UAA-F14/PID-RLC/doc/PY2.pdf

# Proyecto Intermedio - Diseño e Implementación de un Controlador PID Analógico para una Planta RLC de Tercer Orden

Contreras R. Orlando¹

, García B. Iker¹

, Lara H. Kevin¹

1Departamento de Sistemas Electrónicos, Universidad Autónoma de Aguascalientes, Av. Universidad 940, Aguascalientes, 20131, Aguascalientes, México.

Contributing authors: {al348390, al307630, al464376}@edu.uaa.mx;

Abstract

En este proyecto se diseñó, simuló e implementó un controlador PID analógico en forma paralela, construido con amplificadores operacionales TL082, para mejorar la respuesta transitoria de una planta RLC serie subamortiguada. La sintonía inicial se obtuvo por el método de oscilaciones sostenidas de Ziegler-Nichols, Debido a que esta sintonía genera un sobrepaso, se realizó un ajuste fino en MATLAB, con lo cual se obtuvo un sobrepaso de 7.6 %, error en estado estable nulo y un tiempo de asentamiento de 714 µs, menor que los 790 µs de lazo abierto. El diseño se trasladó a valores de resistencias y capacitores y se verificó en LTspice.

Keywords: Control PID, Ziegler-Nichols, Oscilaciones sostenidas, Circuito RLC, Amplificador operacional, Filtro derivativo, MATLAB, LTspice.

## 1 Objetivo

Diseñar, simular, construir y evaluar un controlador PID analógico, implementado con amplificadores operacionales, que mejore la respuesta transitoria de una planta RLC subamortiguada, obteniendo la sintonía inicial mediante el método de oscilaciones sostenidas (Ziegler-Nichols en lazo cerrado) y refinándola mediante simulación en MATLAB, de manera que el sistema en lazo cerrado cumpla con las siguientes especificaciones:
- Error en estado estable nulo (ess = 0).
- Sobrepaso máximo Mp ≤ 15 %.
- Tiempo de asentamiento menor que el de lazo abierto.

## 2 Materiales y Metodología

- Inductor de 10 mH
- Capacitores de 100 nF, 10 nF y 1 nF
- Resistencias y Trimpots
- Amplificadores operacionales TL082
- Fuente de alimentación dual de ±12 V
- Generador de funciones (señal cuadrada de 0 a 1 V, 100 Hz)
- Osciloscopio digital y multímetro
- Protoboard, cables de conexión y sondas

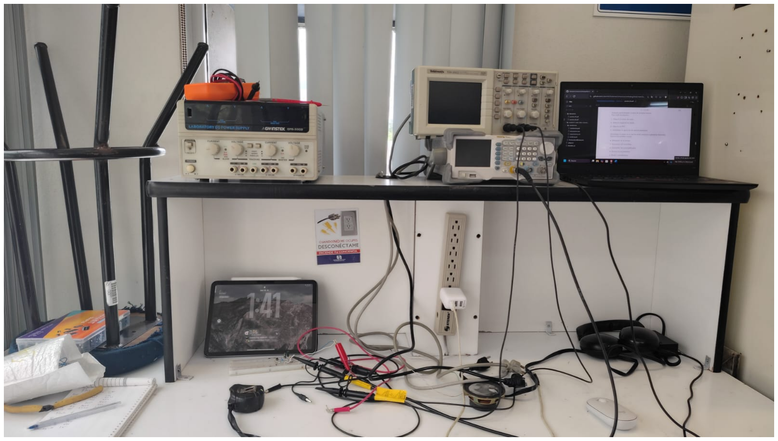
[picture p9: figure]

Fig. 1: Materiales

### 2.1 Modelado de la Planta

La planta se compone de un circuito RLC serie con salida en el capacitor, seguido de un seguidor de tensión, una etapa RC y un segundo seguidor de tensión. La resistencia total del lazo está formada por R50 = 58 Ω y R35 = 100 Ω en serie, más la resistencia DC del inductor (DCR) y la resistencia de salida del amplificador que excita al circuito. La función de transferencia del RLC es

GRLC (s) = VC (s)
U(s)

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
2 + 2ζωns + ω²
n

,

con

ωn =

1
√
LC

=

1
p
(10 mH)(100 nF)

= 31 623 rad/s (5.03 kHz),

ζ =

R
2

r
C
L

=

158.1
2

r
100 nF
10 mH

= 0.25.

El valor de ζ queda dentro del intervalo requerido 0.15 ≤ ζ ≤ 0.35. Para este amortiguamiento, el RLC por sí solo presenta un sobrepaso teórico

Mp = e

−ζπ/√
1−ζ

2
× 100 % = 44.4 %, ts ≈

4
ζωn

= 506 µs.

La etapa RC adicional (R49 = 20 kΩ, C14 = 10 nF) introduce un polo real en

GRC (s) = 1
τs + 1

, τ = R49C14 = 200 µs ⇒ p3 = −5 000 rad/s.

Los seguidores de tensión U20 y U21 aíslan las etapas, de modo que la planta completa resulta en el producto de ambas funciones:

H(s) = GRLC (s) GRC (s) = | ω

2
n
s
| 2 + 2ζωns + ω²
n

1
τs + 1

=

5 × 10¹²
s

3 + 20 811 s

2 + 1.079 × 10⁹ s + 5 × 10¹² ,

cuyos polos son s1,2 = −7 905±j30 618 rad/s y s3 = −5 000 rad/s. La ganancia en DC es H(0) = 1.

### 2.2 Sintonía Inicial: Método de Oscilaciones Sostenidas

Con las acciones integral y derivativa desactivadas (Ki = 0, Kd = 0), se incrementó la ganancia proporcional hasta obtener una oscilación sostenida de amplitud constante a la salida, sin saturar los amplificadores. En el modelo, la ganancia última se obtiene con margin(H) como el margen de ganancia, y el periodo último a partir de la frecuencia de cruce de fase de −180◦
:
Kcr = 3.49 (10.86 dB), | ωcr = 32 848 rad/s, | Pcr =

2π

ωcr

= 191.3 µs (5.23 kHz).

El mismo resultado se observa en el lugar de las raíces (Figura ??), donde las ramas de los polos complejos cruzan el eje imaginario en s = ±j32 848 rad/s para K = 3.49.

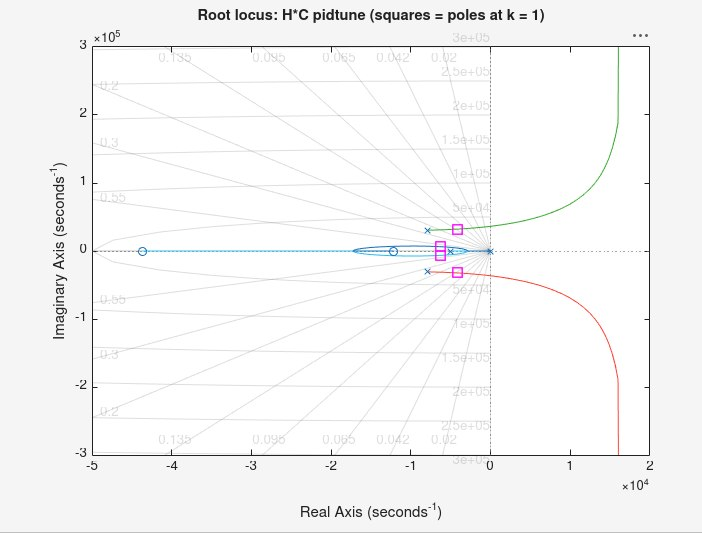
[picture p10: figure]

Fig. 2: Lugar de las raíces de H(s) con control proporcional.

Aplicando la tabla de Ziegler-Nichols para un controlador PID:

Kp = 0.6Kcr = 2.09, Ti =

Pcr
2

= 95.6 µs, Td =

Pcr
8

= 23.9 µs,

y las ganancias independientes de cada rama del circuito son

Ki =

Kp
Ti

= 2.19 × 10⁴
s

−1

, Kd = KpTd = 5.0 × 10⁻⁵
s.

### 2.3 Simulación y Ajuste Fino en MATLAB

El controlador se modeló en forma paralela,

C(s) = Kp +

Ki
s

+ Kds,

y el lazo cerrado con realimentación unitaria como Gp(s) = C(s)H(s) 1 + C(s)H(s)
. Se simuló

la respuesta al escalón con step y se obtuvieron las métricas con stepinfo (criterio de asentamiento del 2 %). El código completo se presenta en el Apéndice ??.

La sintonía de Ziegler-Nichols produce una respuesta rápida, pero con Mp = 18.2 %, que excede la especificación de 15 %. A partir de ella, el ajuste fino se realizó con el siguiente criterio:

1. Reducción de Kp de 2.09 a 1.5: el sobrepaso de Ziegler-Nichols proviene principalmente de la cercanía a la ganancia crítica (Kp/Kcr = 0.6). Al reducir la relación a 0.43, los polos dominantes se alejan del eje imaginario y el sobrepaso disminuye.
2. Reducción de Ki de 2.19×10⁴ a 1.2×10⁴
s

−1
(Ti = 125 µs): una acción integral más suave reduce la acumulación de error durante el transitorio y el sobrepaso asociado, sin perder el error en estado estable nulo.
3. Aumento de Kd de 5.0×10⁻⁵ a 6.7×10⁻⁵
s (Td = 44.7 µs): la acción derivativa adicional aporta fase en la zona de cruce y amortigua el modo oscilatorio del RLC.

Con estos valores, el lazo cerrado tiene polos en −5 655 ± j35 027 rad/s y −4 751 ± j5 009 rad/s, un margen de ganancia de 28.5 dB y un margen de fase de 81.6

◦
(Figura
??).

### 2.4 Diseño del Circuito

El controlador se implementó en forma paralela (Figura ??) con cinco etapas:
- Restador (U15): con R36 = R37 = R38 = R39 = 10 kΩ entrega e(t) = r(t)−y(t), donde y(t) es la salida del seguidor U21.
- Rama proporcional (U16): amplificador inversor con ganancia −R43/R40.
- Rama integral (U17): integrador inversor con función de transferencia −1/(R41C12s).
- Rama derivativa (U18): derivador inversor con R42 en serie con C13, que limita la ganancia en alta frecuencia (filtro derivativo):

CD(s) = −

R44C13 s
R42C13 s + 1

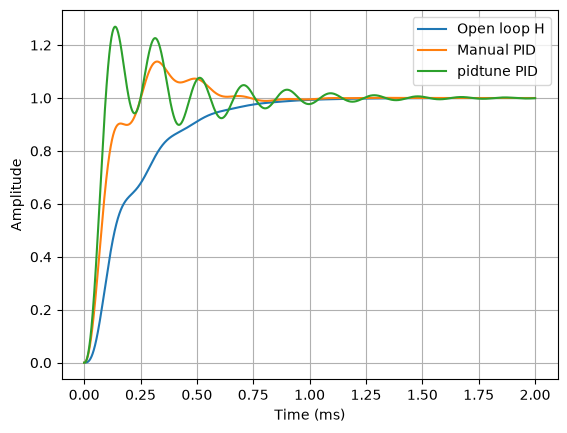
[picture p11: figure]

Fig. 3: Comparación PID manual y PID-Tune

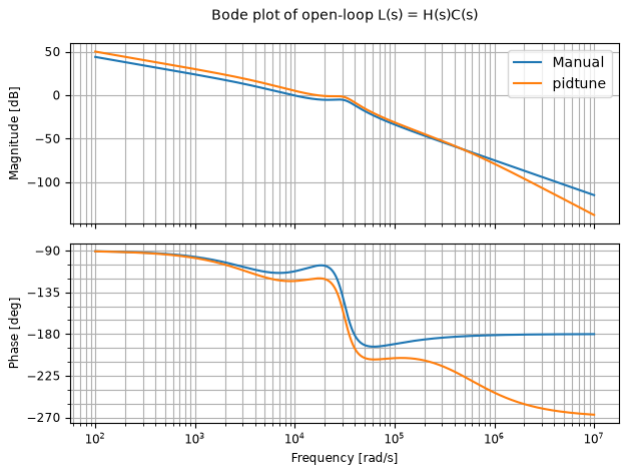
[picture p12: figure]

Fig. 4: Diagrama de Bode de la planta H(s) y del lazo abierto compensado C(s)H(s).

- Sumador inversor (U19): con R45 = R46 = R47 = R48 = 10 kΩ suma las tres ramas y corrige el signo, de modo que la doble inversión entrega u(t) con signo positivo.

Los valores de componentes se obtuvieron a partir de las ganancias finales (Tabla ??).

Table 1: Cálculo de los componentes del PID analógico.

Rama | Relación | Componentes | Ganancia obtenida
P | Kp = R43/R40 | R40 = 10 kΩ, R43 = 15 kΩ | Kp = 1.5
I | Ki = 1/(R41C12) | R41 = 83.33 kΩ, C12 = 1 nF | Ki = 1.2 × 10⁴ s⁻¹
D | Kd = R44C13 | R44 = 65 kΩ, C13 = 1 nF | Kd = 6.5 × 10⁻⁵ s
Filtro D | τf = R42C13 | R42 = 2.4 kΩ | τf = 2.4 µs

R41 = 83.33 kΩ no es un valor comercial; se implementa con 82 kΩ + 1.3 kΩ en serie o con un potenciómetro de 100 kΩ ajustado. Para R44 se usó 65 kΩ, lo que da Kd = 6.5×

10⁻⁵

s, 3 % por debajo del valor de diseño; con 68 kΩ (E12) se obtendría 6.8 × 10⁻⁵ s.
El polo del filtro derivativo queda en 1/τf = 417 krad/s, unas 13 veces por encima de ωn, de modo que no afecta la dinámica de interés y sí limita la amplificación del ruido de alta frecuencia. Para el reinicio del integrador se agrega un interruptor en paralelo con C12, que se cierra durante la búsqueda de Kcr y antes de cada prueba al escalón.

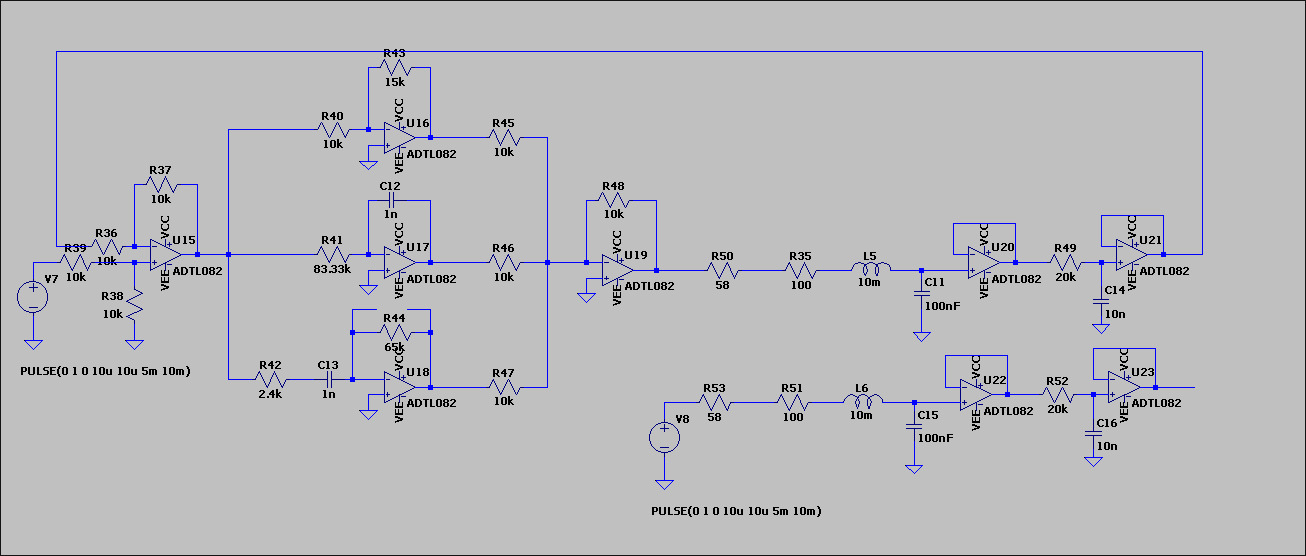
[picture p13: figure]

Fig. 5: Esquemático en LTspice del sistema completo: restador, ramas P, I y D, sumador, planta RLC con etapa RC en lazo cerrado (arriba) y planta en lazo abierto de referencia (abajo).

En LTspice se simuló el sistema completo con amplificadores TL082 y una señal de referencia PULSE(0 1 0 10u 10u 5m 10m). Además del lazo cerrado, se incluyó una copia de la planta excitada directamente por la misma señal (V8), para comparar las respuestas de lazo abierto y lazo cerrado en una sola simulación.

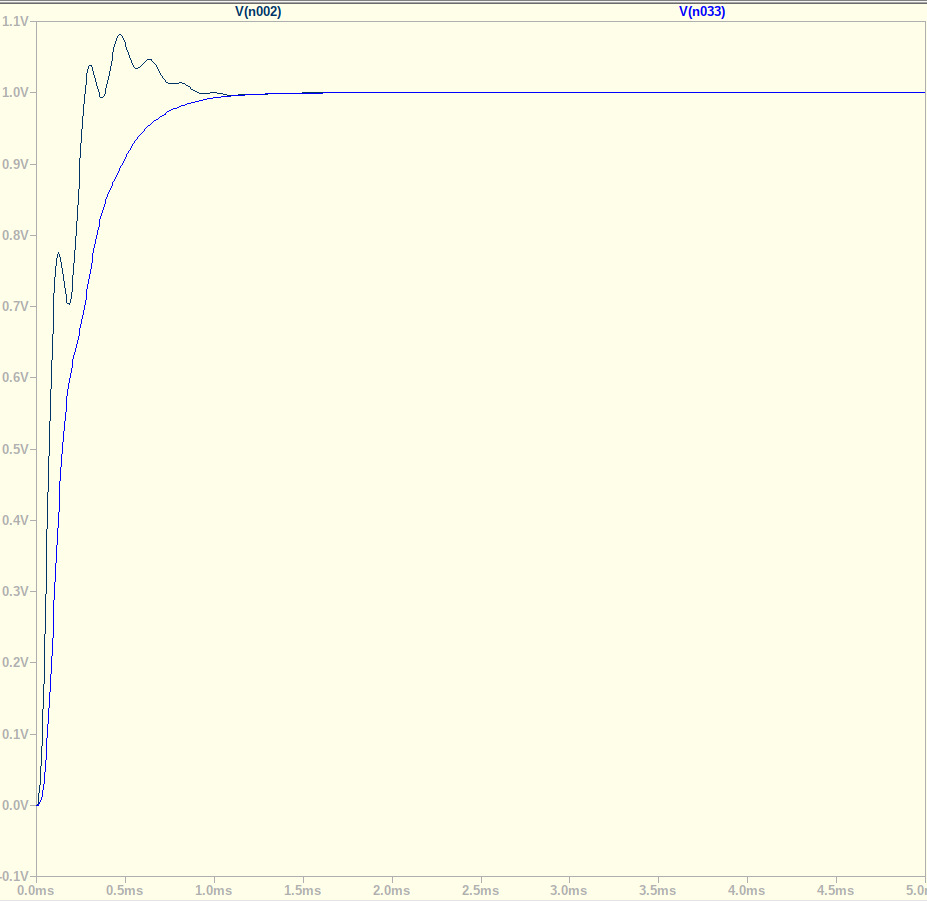
[picture p14: figure]

Fig. 6: Comparación planta sin control y con control

## 3 Resultados

### 3.1 Comparación de las Respuestas Simuladas

La Figura ?? compara la respuesta al escalón de la planta en lazo abierto, el lazo cerrado con la sintonía de Ziegler-Nichols y el lazo cerrado con el ajuste fino. La Tabla ?? resume las métricas obtenidas con stepinfo.

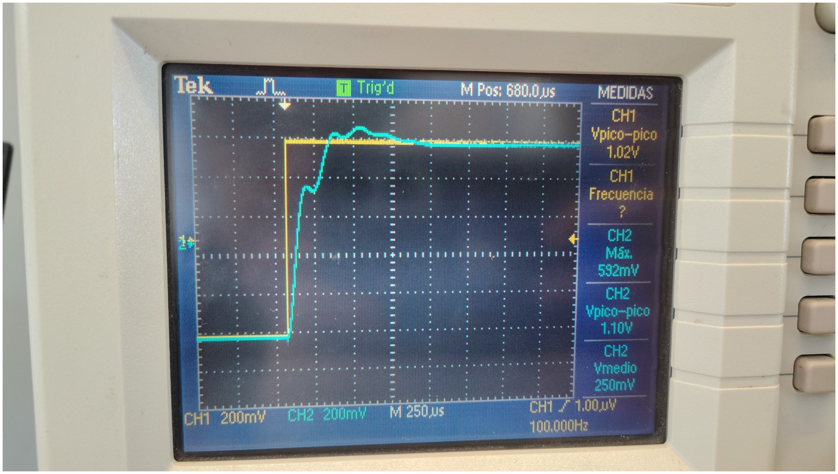
[picture p15: figure]

Fig. 7: Respuesta al escalón unitario

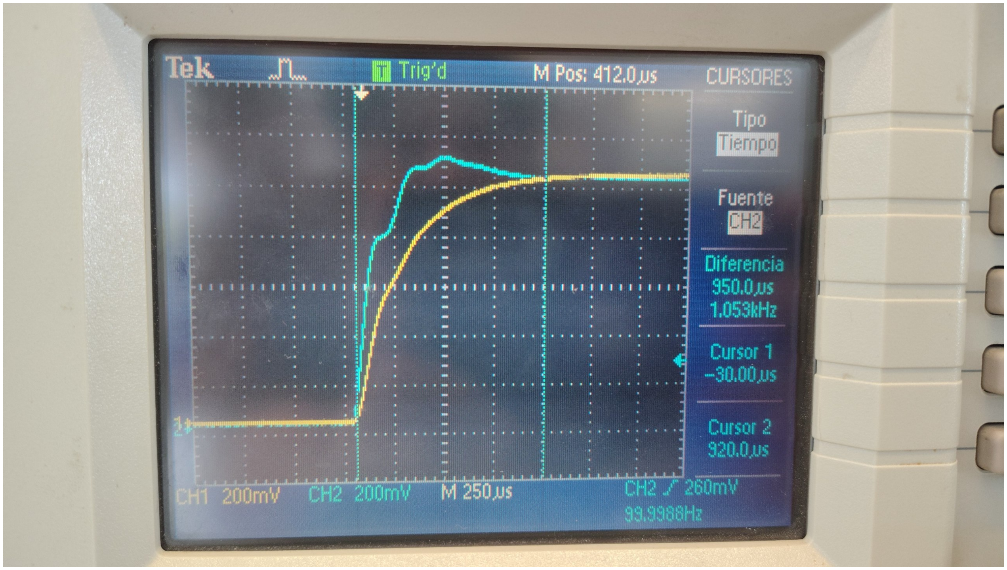
[picture p16: figure]

Fig. 8: Comparación planta sin control y con control

Table 2: Métricas de la respuesta al escalón (criterio de asentamiento del 2 %).

Métrica | Lazo abierto | PID Z-N | PID ajustado | PID circuito∗
Tiempo de subida tr | 422 µs | 71 µs | 213 µs | 212 µs
Tiempo pico tp | – | 304 µs | 462 µs | 463 µs
Sobrepaso Mp | 0 % | 18.2 % | 7.6 % | 8.1 %
Tiempo de asentamiento ts | 790 µs | 615 µs | 714 µs | 708 µs
Error en estado estable ess | 0 | 0 | 0 | 0

∗Valores reales de componentes, incluyendo el filtro derivativo (τf = 2.4 µs).

La sintonía de Ziegler-Nichols reduce el tiempo de asentamiento a 615 µs, pero su sobrepaso de 18.2 % no cumple la especificación. El PID con ajuste fino cumple las tres especificaciones: Mp = 7.6 % ≤ 15 %, ess = 0 gracias a la acción integral y ts = 714 µs < 790 µs. Además, reduce el tiempo de subida casi a la mitad respecto al lazo abierto (213 contra 422 µs). Con los valores reales de componentes, el filtro derivativo y la diferencia en R44 apenas modifican la respuesta (Mp = 8.1 %, ts = 708 µs).

Cabe señalar que la mejora en el tiempo de asentamiento es moderada (≈ 10 %), ya que la planta de tercer orden no presenta sobrepaso en lazo abierto, y el PID cambia una respuesta lenta sin sobrepaso por una más rápida con un sobrepaso pequeño. La principal ganancia del controlador está en la velocidad de respuesta (tr) y en la robustez del error en estado estable nulo ante variaciones de la planta.

## 4 Análisis y Discusión

Las diferencias esperadas entre la simulación y la medición se deben a varios factores:
- Resistencia DC del inductor y resistencia de salida del amplificador: ambas se suman a los 158 Ω de la resistencia serie, por lo que incrementan ζ. Por ejemplo, una DCR de 20 Ω elevaría ζ de 0.25 a 0.28, lo que modifica Kcr y Pcr.
- Tolerancias de los componentes: un error de ±10 % en L o C desplaza ωn cerca de un ±5 %. Las tolerancias de R49 y C14 cambian el polo dominante de la etapa RC, que es el que más influye en el tiempo de asentamiento.
- Producto ganancia-ancho de banda (GBW): el TL082 tiene un GBW de 3 MHz. A la frecuencia de oscilación (5.23 kHz) las ramas P e I operan sin problema, pero el derivador tiene ganancia alta en frecuencia, por lo que su respuesta real se aparta del modelo ideal por encima de unos cientos de kHz y añade un desfase adicional al lazo.
- Saturación y slew rate: el pico derivativo ante el escalón satura la rama D durante algunos microsegundos. Además, el slew rate del TL082 (13 V/µs) limita la rapidez de ese pico.
- Limitaciones del método de Ziegler-Nichols: es una regla empírica que busca una razón de decaimiento de aproximadamente 1/4, por lo que suele producir sobrepasos altos (18.2 % en este caso). Además, requiere llevar el sistema al límite de estabilidad, lo que en un sistema real implica el riesgo de saturar los amplificadores durante la prueba. Por ello, la sintonía obtenida se toma solo como punto de partida para el ajuste fino.

## 5 Conclusiones

Se diseñó un controlador PID analógico en forma paralela para una planta RLC de tercer orden con ωn = 31.62 krad/s y ζ = 0.25. La etapa RC adicional permitió que la planta alcanzara el límite de estabilidad con una ganancia proporcional finita (Kcr = 3.49, Pcr = 191.3 µs), lo que hizo posible aplicar el método de oscilaciones sostenidas de Ziegler-Nichols.

La sintonía de Ziegler-Nichols (Kp = 2.09, Ti = 95.6 µs, Td = 23.9 µs) produjo una respuesta rápida pero con un sobrepaso de 18.2 %, que no cumple la especificación. El ajuste fino en MATLAB, que redujo Kp y Ki y aumentó Kd, llevó a Kp = 1.5, Ki = 1.2×10⁴
s

−1 y Kd = 6.7×10⁻⁵
s, con lo que se cumplen las tres especificaciones: Mp = 7.6 %, ess = 0 y ts = 714 µs, menor que los 790 µs de lazo abierto, con márgenes de estabilidad amplios (28.5 dB y 81.6

◦
). La simulación con los valores reales de componentes y con saturación de ±12 V confirmó que el diseño mantiene su desempeño (Mp = 8.6 %, ts = 717 µs).

Como áreas de mejora, se identificó que el polo de la etapa RC (5 000 rad/s) domina la dinámica de la planta y limita la mejora alcanzable en el tiempo de asentamiento; reducir τ acercaría el comportamiento al del RLC y dejaría más margen al controlador.

## References

[1] K. Ogata, Ingeniería de Control Moderna, 5.ª ed. Madrid: Pearson, 2010.
[2] J. G. Ziegler y N. B. Nichols, “Optimum settings for automatic controllers,” Transactions of the ASME, vol. 64, pp. 759–768, 1942.
[3] K. J. Åström y T. Hägglund, PID Controllers: Theory, Design, and Tuning, 2.ª ed. Research Triangle Park, NC: ISA, 1995.
[4] Texas Instruments, TL08xx JFET-Input Operational Amplifiers, hoja de datos.

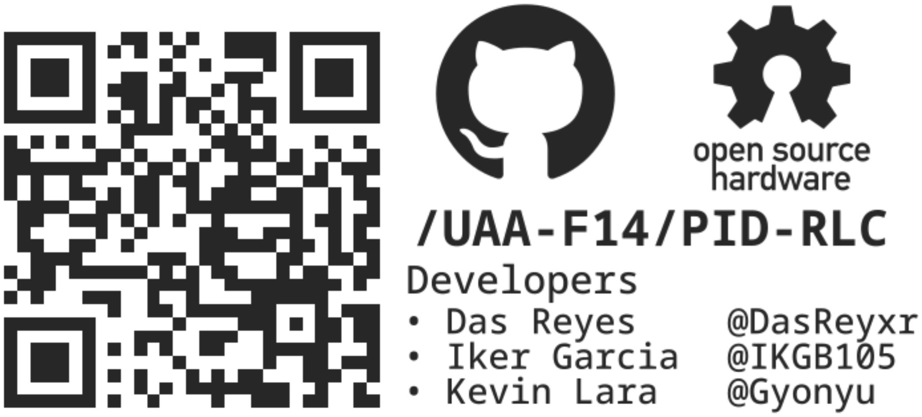
[picture p17: figure]
