UAA-F14/PID-RLC/doc/rlc_pid.pdf

## Overshoot Elimination in a Series RLC Circuit via Analog PID Control

Electronic Engineering Technical Documentation

Project Logbook

Version 0.2 — October 10, 2026

Abstract
This document describes the design, classical control analysis, and SPICE simulation of an analog PID controller applied to a series RLC circuit, with the goal of eliminating the step-response overshoot inherent to its underdamped open-loop dynamics. This is the first of two related projects; the second applies the same PID design methodology to a buck converter (repository BUCK_1 covers an earlier, IC-based adjustable buck design, not the PID-controlled version). Documented as an honest engineering logbook: every result is marked as calculated, simulated, or pending — never filled in with invented placeholder data. The plant is fixed and its open-loop overshoot confirmed both analytically (52.7%) and in SPICE (52.68%). The PID gains are derived via pole placement (Kp ≈ 27.87, Ki ≈ 455,905, Kd ≈ 3.114 × 10⁻⁴ )
and the op-amp compensator topology is defined. Still open: the specific R/C component values realizing those gains, the full closed-loop schematic, and its SPICE validation — explicitly marked PENDING.

### Contents

1 Project Objective | 3
2 Plant: Series RLC Circuit | 3
3 Open-Loop Transfer Function | 4
4 PID Controller Design | 4
5 Op-Amp Compensator Circuit | 7

1

Series RLC with Analog PID Control – Project Logbook | 2
6 SPICE Simulation (LTspice) | 11
7 Conclusions | 13

### 1 Project Objective

Design and validate an analog PID controller, implemented with operational amplifiers, that closes the loop around a series RLC circuit and eliminates the overshoot present in its open-loop step response, using classical control design methods (transfer function derivation, root locus / pole placement). This project establishes the PID design methodology later applied to a discrete, analog-PID-controlled buck converter (a separate, subsequent project).

### 2 Plant: Series RLC Circuit

### 2.1 Design criteria

Component values were not assigned; they were chosen to satisfy two criteria: (1) clearly underdamped (ζ well below 1) so the open-loop overshoot is unambiguous, and (2) a natural frequency practical for breadboard construction and standard lab equipment (function generator + oscilloscope), avoiding both breadboard-parasitic-dominated frequencies (too high) and impractically long observation times (too low).

Table 1: Design targets and resulting component values

Parameter | Value | Source
Target natural frequency, f0 | 5 kHz | Defined by design
Target damping ratio, ζ | 0.2 (underdamped, ≈53 % overshoot
| target) | Defined by design
Capacitance, C | 100 nF | Defined by design
| | (standard value)
Inductance, L | 10.13 mH | Calculated, Sec. 2.2
Resistance, R | 127.32 Ω | Calculated, Sec. 2.2

### 2.2 Component value derivation

With ωn = 2πf0 = 2π(5000) ≈ 31,416 rad/s, and the standard series-RLC relations:

L =

1
ω²
nC

(1)

R = 2ζ

p
L/C | (2)

L =

1
(31416)²(100 × 10⁻⁹)
= 10.13 mH | (3)

R = 2(0.2)r
10.13 × 10⁻³
100 × 10⁻⁹
= 127.32 Ω | (4)

### 3 Open-Loop Transfer Function

With the capacitor voltage VC as the output and the source voltage Vin as the input, the standard second-order series-RLC transfer function is:

VC(s)
Vin(s)

=

1/LC

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
2 + 2ζωns + ω²
n

(5)

with ωn = 1/

√
LC and ζ =

R
2

p
C/L, confirming the values imposed by design in Section 2.

### 3.1 Predicted open-loop overshoot

For an underdamped second-order system, the standard closed-form percent overshoot for a step input is:

%OS = exp

−πζ
p
1 − ζ

2

!
× 100 | (6)

With ζ = 0.2: %OS = exp
−π(0.2)
√

1 − 0.04
× 100 ≈ | 52.7% | .

This confirms the plant has substantial, clearly-visible open-loop overshoot – a real problem for the PID controller (Section 4) to solve, not a marginal one.

### 3.2 SPICE confirmation

Simulated. The circuit was built directly in LTspice (series R-L-C, driven by a 1 V step via a PULSE source, VC probed at the L-C junction, .tran 2m). The peak and final values were extracted numerically from the .raw binary file (not read visually from the plot):

Peak VC | 1.526,79 V, at t = 102.28 µs
Final (settled) VC | 1.000,00 V
Overshoot | (1.52679 − 1)/1 × 100 = | 52.68%

This matches the analytical prediction (52.7%) to within 0.02 percentage points, validating both the transfer-function derivation and its SPICE implementation before any control is added.

### 4 PID Controller Design

### 4.1 Parallel vs. series PID form

Two classical structures exist for a PID compensator:

Parallel (ideal): C(s) = Kp +

Ki
s
+ Kds | (7)

Series (interacting): C(s) = Kc

1 +

1
Tis
(1 + Tds) | (8)

The series form is what results naturally from cascading a PI stage into a PD stage (fewer op-amps), but its effective gains interact: expanding it gives Kp = Kc(1 + Td/Ti), Ki = Kc/Ti ,
Kd = KcTd – changing Ti also moves the effective Kp. The parallel form was chosen for this design: each gain (Kp, Ki

, Kd) is independently tunable, which maps directly onto the pole-placement method used below (Section 4.3) and is more straightforward to justify/defend gain-bygain.

### 4.2 Why the closed-loop system is third order

The plant G(s) (Section 3) is second order (two energy-storage elements, L and C). The controller contributes exactly one additional pole, at s = 0, from the integral term alone – the P and D terms add no poles. The full derivation, step by step:
Step 1 – combine C(s) into a single fraction (common denominator s):

C(s) = Kp +

Ki
s

+ Kds =

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
2 + Kps + Ki

s

(9)

Step 2 – multiply C(s)G(s):

C(s)G(s) = Kds

2 + Kps + Ki

s

·

ω

2
n
s

2 + 2ζωns + ω²
n

=

ω

2
n
Kds

2 + Kps + Ki

s (s

2 + 2ζωns + ω²
n

)

(10)

Step 3 – the characteristic equation is 1 + C(s)G(s) = 0. Clearing the denominator (multiplying through by it):

s

s

2 + 2ζωns + ω

2
n
+ ω

2
n
Kds

2 + Kps + Ki
= 0 | (11)
Step 4 – expand each product separately. First term:

s

s

2 + 2ζωns + ω

2
n
= s

3 + 2ζωns

2 + ω

2
n
s | (12)

Second term:
ω

2
n
Kds

2 + Kps + Ki
= ω

2
nKds

2 + ω

2
nKps + ω

2
nKi | (13)
Step 5 – add both expansions and group by power of s:

s

3
term: s
3 | (14)

s

2
terms: 2ζωns

2 + ω

2
nKds

2 =
2ζωn + ω

2
nKd
s
2 | (15)

s

1
terms: ω

2
n

s + ω

2
nKps = ω

2
n
(1 + Kp)s | (16)

s

0
term: ω

2
nKi | (17)

s

3 +
2ζωn + ω

2
nKd
s

2 + ω

2
n

(1 + Kp)s + ω

2
nKi = 0 | (18)

The degree-3 result is not a choice – it is forced by combining a 2nd-order plant with a PID (which has exactly 3 free gains, matching the 3 non-leading coefficients of a cubic). The lone s left over from the integrator in Step 1 is what multiplies against the plant’s s

2 | in Step 4, producing s

3
;
without an integral term, C(s)G(s) would only reach s

2
in the denominator and the closed loop would be 2nd order. This is precisely why full pole placement – choosing all three closed-loop poles arbitrarily – is achievable here: 3 unknowns for exactly 3 equations.

### 4.3 Pole placement

Criterion for pole selection: all three closed-loop poles are chosen real and negative. A complexconjugate pole pair is what produces oscillation/overshoot in a 2nd-order system (Section 3); by construction, an all-real-pole 3rd-order system has no oscillatory mode, guaranteeing zero overshoot regardless of the specific gains that produce those poles.
A dominant-pole design was used: one slower pole sets the observable response speed, and two much faster poles (whose transients decay quickly and barely influence the visible response) push the system to behave like a well-damped first-order system. Target: an improvement over the open-loop settling time (ts ≈ 4/(ζωn) ≈ 637 µs, Section 3) without demanding unrealistically large gains. Using ts ≈ 4/|pdominant| for a target ts ≈ 200 µs:

|pdominant| =

4
200 × 10⁻⁶
= 20,000 rad/s | (19)

with the two non-dominant poles placed ∼7.5× further out:

p1 = −20,000 rad/s, | p2 = p3 = −150,000 rad/s | (20)

### 4.4 Gain calculation (coefficient matching)

Expanding the desired closed-loop polynomial from the chosen poles:

(s + 20000)(s + 150000)² = s

3 + 320000 s

2 + 28,500,000,000 s + 4.5 × 10¹⁴ | (21)

Matching term-by-term against Section 4.2’s characteristic equation (with ζ = 0.2, ωn ≈ 31,416 rad/s, ω

2

n ≈ 9.8717 × 10⁸
, 2ζωn ≈ 12566):

s

2
: 2ζωn + ω

2
nKd = 320000 ⇒ Kd =

320000 − 12566
9.8717 × 10⁸

≈ 3.114 × 10⁻⁴
(22)

s

1
: ω

2
n

(1 + Kp) = 2.85 × 10¹⁰ ⇒ Kp =

2.85 × 10¹⁰
9.8717 × 10⁸
− 1 ≈ 27.87 | (23)

s

0
: ω

2

nKi = 4.5 × 10¹⁴ ⇒ Ki =

4.5 × 10¹⁴
9.8717 × 10⁸
≈ 455,905 | (24)
Kp ≈ 27.87, | Ki ≈ 455,905, | Kd ≈ 3.114 × 10⁻⁴
(25)

Verified. Substituting Kp, Ki

, Kd back into the characteristic equation of Section 4.2 reproduces the target polynomial of Section 4.3 to within rounding (e.g. the s

| | 2 coefficient comes out to 319,907
against a target of 320,000, a 0.03% difference from rounding Kd to 4 significant figures).

### 4.5 Frequency-domain verification

As an independent cross-check (not the design method itself – Sections 4.2–4.4 already place all three poles exactly by construction), the open-loop L(s) = C(s)G(s) and closed-loop T(s) = L(s)
1+L(s)
frequency responses were computed numerically (simulation/bode_plot.py, using scipy.signal, not hand-sketched) from the actual G(s) and C(s) derived above.


Figure 1: Open-loop L(s) magnitude/phase (left) and closed-loop T(s) magnitude/phase (right), computed from the actual plant and controller transfer functions.

The single gain crossover (|L(jω)| = 0 dB) occurs at ωc ≈ 317,861 rad/s, with phase margin PM ≈ 76.3

- – a healthy margin (above the usual 45–60◦ design target). The open-loop phase never reaches −180◦ across the swept range (10⁻¹
to 10⁷
rad/s), so there is no classical gain-margin crossover to report; this is consistent with the all-real-closed-loop-pole design (Section 4.3), which by construction has no oscillatory mode. The closed-loop magnitude shows a small (≈1 dB) peak near 1–2 × 10⁵
rad/s before rolling off, and stays flat near 0 dB well below that – consistent with good reference tracking without excessive resonant peaking.

PENDING

Whether the derivative term is implemented as a full analog PID or simplified to PI-only for noise immunity (Section 5) – if Kd is implemented, it must be through the filtered/bandlimited derivative discussed in Section 5, not an ideal differentiator, since an ideal derivative would amplify any high-frequency noise on the feedback signal.

### 5 Op-Amp Compensator Circuit

### 5.1 Topology: five op-amp stages

The parallel PID (Section 4.1) is realized as five op-amp stages: a difference amplifier computing the error, three parallel branches (P, I, filtered-D) acting on that error, and a summing amplifier recombining them.

General basis: the inverting amplifier

Every branch below is a special case of the same ideal-op-amp result (virtual ground at the inverting input + KCL at that node, standard inverting-amplifier analysis):

Vout

Vin

= −

Zf

Zin

(26)

where Zin and Zf are the input and feedback impedances. Only the choice of components placed in those two positions changes between branches:
1. Difference amplifier: computes e(t) = Vref −VC from the reference and the plant’s feedback signal (standard four-resistor differential amplifier). [See Figure 2.]
2. Proportional branch: Zin = Rp, Zf = Rf p:

Vout,P
e

= −

Rf p
Rp

⇒ Kp =

Rf p
Rp

(27)

[See Figure 4.]
3. Integral branch: Zin = Ri

, Zf =

1
sCi

Vout,I
e

= −

1/(sCi)
Ri

= −

1
sRiCi

⇒ Ki =

1

RiCi

(28)

[See Figure 5.] (division by s in Laplace corresponds to integration in time, hence Vout,I = −

1
RiCi

R
e dt).
4. Filtered-derivative branch: Zin = R1 +

1
sCd

, Zf = Rf d:

Vout,D
e

= −

Rf d
R1 +

1
sCd

=

−Rf dCd s
1 + sR1Cd

(29)

giving Kd = Rf dCd at low frequency, capped at −Rf d/R1 above the corner frequency fpole = 1/(2πR1Cd) – this avoids amplifying high-frequency noise, unlike an ideal differentiator (R1 = 0, bare capacitor), whose gain grows unboundedly with frequency. [See Figure 6.]
5. Summing amplifier: recombines the three branch outputs (each through an equal input resistor Rs, feedback Rfs) into u(t) = Kpe + Ki

R
e dt + Kd

de
dt , which drives the plant. [See Figure 3.]

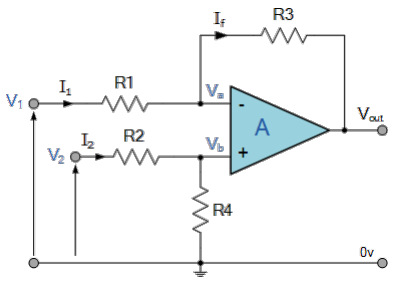
[picture p18: figure]

Figure 2: Differential Amplifier

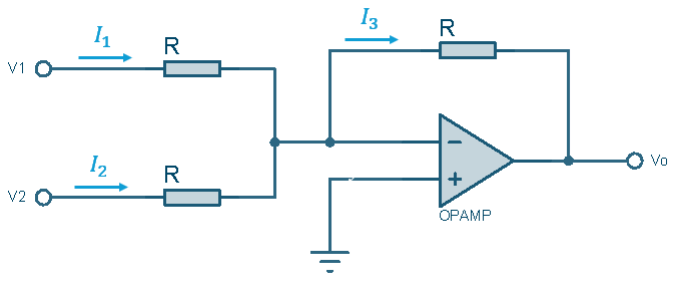
[picture p19: figure]

Figure 3: Summing Implementation


Figure 4: Proportional | Figure 5: Integral

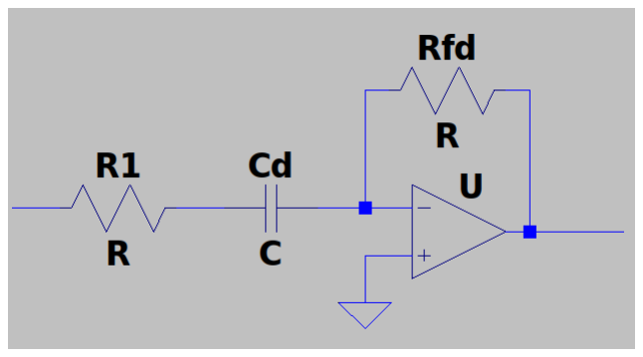
[picture p20: figure]

Figure 6: Filtered-Derivative

### 5.2 Component values

Design choice: Rp = Ri = Rf d = 10 kΩ (a common reference value across stages – reduces distinct BOM part count, and 10 kΩ is a practical general-purpose value for op-amp input resistors: high enough to not load the driving stage’s output, low enough that op-amp input bias current and noise stay negligible). The remaining component in each branch follows directly:

Rf p = KpRp = 27.87 × 10,000 ≈ 278.7 kΩ | (30)

Ci =

1
KiRi

=

1
455,905 × 10,000
≈ 219.3 pF | (31)

Cd =

Kd

Rf d

=

3.114 × 10⁻⁴

10,000

≈ 31.14 nF | | (32)

Filtered-derivative corner frequency and R1

The corner (pole) frequency of the filtered-derivative branch, in rad/s, is ωpole = 1/(R1Cd) (the pole of 1 + sR1Cd). Below ωpole the branch acts as a real differentiator (gain growing with frequency, providing the intended phase lead within the control loop’s bandwidth); above it, the gain flattens at a fixed value Rf d/R1 instead of continuing to grow, which is what prevents high-frequency noise from being amplified without bound. Criterion: place ωpole comfortably above the gain crossover frequency (≈ 317,861 rad/s, Section 4.5) so the entire control-relevant frequency range sees real derivative action, with the noise-limiting flattening only taking effect well beyond it. Choosing ωpole ≈ 2 × 10⁶
rad/s (≈ 6.3× the gain crossover):

R1 =

1

ωpoleCd

=

1
(2 × 10⁶)(31.14 × 10⁻⁹)
≈ | 16.06 Ω | (33)

Summing and difference amplifiers

Summing amplifier: each branch (P, I, D) already carries its own gain (Kp, Ki

| | , Kd) from its own
stage, so the summer only needs to add the three signals with unity gain, which requires equal input and feedback resistors: Rs = Rfs = 10 kΩ (consistent with the rest of the design).
Difference amplifier: the standard 4-resistor differential amplifier gives unity gain (e = Vref − VC exactly, no scaling) when all four resistors are equal: all four set to 10 kΩ.

### 5.3 Full schematic, by stage

Shown one stage at a time (clearer to build from than a single combined diagram). Signal flow: Vref and VC (feedback) → difference amp → e(t) → P/I/D branches in parallel → summing amp → u(t) → plant (series RLC, Section 3) → VC, closing the loop.

−

+

VC (feedback)

10k

Vref

10k

10k

10k

e(t) = Vref − VC

Figure 7: Stage 1 – difference amplifier. All four resistors 10kΩ. Vref → (+), VC → (−), giving e = Vref − VC (not the reverse).

e(t)

Rp=10k
−

+

Rf p ≈ 278.7k

−Kp e

Figure 8: Stage 2 – P branch. Simple inverting amplifier. Kp = Rf p/Rp ≈ 27.87.

e(t)

Ri=10k
−

+

Ci ≈ 219.3p

−Ki

R
e dt

Figure 9: Stage 3 – I branch. Same as P, but a capacitor instead of a resistor in the feedback path – that is what makes it an integrator. Ki = 1/(RiCi) ≈ 455,905.

e(t)

R1 ≈ 16.06Ω Cd ≈ 31.14n

−

+

Rf d=10k

−Kde˙ (filtered)

Figure 10: Stage 4 – filtered D branch. The input is R1 in series with Cd (not a bare capacitor – that would be an ideal, noise-amplifying differentiator). This caps the gain above fpole = 1/(2πR1Cd).

−Kpe

Rs=10k

−Ki

R
e dt

Rs=10k

−Kde˙

Rs=10k

−

+

Rfs=10k

u(t)

Figure 11: Stage 5 – summing amplifier. The three inputs already carry their own gain; the summer just adds them (unity gain, Rs = Rfs). Its output u(t) drives the plant (series RLC, Section 3) in place of the step source used for the open-loop test.

Simulated. Built exactly as above in LTspice and run closed-loop, with Vref as a PULSE(0 1 0 10u 10u 10 10) source (same 1V step as the open-loop test, 10µs rise time – see Section 6.1 for why an idealized 1ns rise time was rejected). Op-amps modeled with LTspice’s opamp subcircuit (.lib opamp.sub), Aol = 100k, GBW raised above the library default of 10MHz to keep each stage’s own bandwidth well clear of the loop dynamics (Section 6.2).

Possible failure point: parasitic capacitance on Ci

Ci ≈ 219.3 pF is small enough that breadboard/PCB stray capacitance (typically 1 pF to 5 pF for a breadboard node) is a non-negligible fraction of it (≈1–2%). If the built integrator’s measured Ki deviates noticeably from the calculated 455,905, this parasitic pickup – not necessarily a design or calculation error – should be the first thing checked, before re-deriving the gains. Mitigation if it proves significant: reduce Ri (increasing Ci proportionally to keep the same Ki = 1/(RiCi), at the cost of loading the source driving this branch more).

### 6 SPICE Simulation (LTspice)

### 6.1 Open-loop

Done – see Section 3.1 (52.68% simulated vs. 52.7% predicted, extracted numerically from the .raw file).

### 6.2 Closed-loop: debugging

Two real issues were hit and resolved before a valid closed-loop result was obtained – documented here since both are genuine, non-obvious LTspice pitfalls, not modeling mistakes in the design itself.

### 1. Undefined subcircuit. The first run failed with "This sub-circuit name is not defined"

for all five op-amps. Cause: LTspice’s basic opamp symbol is not auto-linked to its model – its own description text says "You must .lib opamp.sub". Fix: added .lib opamp.sub as a schematic text directive.
2. Numeric overflow (∼ 4 × 10³⁸V). With the missing-library issue fixed, the first successful netlist run produced an output that grew to floating-point overflow – the signature of positive feedback / loop instability, not a slowly-diverging but otherwise sane result. The generated netlist was checked node-by-node against the intended design (Sections 4.4–5) and matched exactly – no wiring error. The actual cause: LTspice’s opamp model is not truly ideal even at its default settings – it carries a finite gain-bandwidth product, GBW=10Meg (10MHz), by default. With Kp ≈ 27.87, the P-branch’s own bandwidth is only GBW/Kp ≈ 358 kHz, close enough to the design’s own dynamics (D-branch corner ≈ 318 kHz, Section 5) that the cumulative phase lag from five cascaded finite-bandwidth stages ate into the phase margin (Section 4.5) enough to destabilize the loop. Fix: raised GBW well above this design’s frequencies of interest, confirming the diagnosis (the instability disappeared).

### 6.3 Closed-loop: result

With both issues resolved, the closed-loop step response was obtained:

Peak VC | 1.115,39 V, at t = 17.37 µs
Final (settled) VC | 0.999,99 V
Overshoot | (1.11539 − 1)/1 × 100 = | 11.54%
Settled within ±2% by t ≈ 31.5 µs

This is a large improvement over the 52.68 % open-loop result, but not the 0 % predicted by the all-real-closed-loop-pole design criterion of Section 4.3. Two hypotheses were tested:
Hypothesis A (rejected): step edge speed exciting the D-branch. The reference step’s rise time was changed from an idealized 1ns to a more realistic 10 µs (10,000× slower). Overshoot only dropped from 13.26 % to 11.54 %, and the peak timing barely moved (11.3→17.4 µs) – far too small a change for edge speed to be the dominant cause. Rejected by this data.
Hypothesis B (supported): closed-loop zero near the dominant pole. The all-real-pole design criterion (Section 4.3) is sufficient to rule out any oscillatory pole, but the closed-loop transfer function also has zeros, from the PID’s own numerator (Kds

2 + Kps + Ki = 0) – not accounted for in the original pole-placement criterion. Solving for the actual zeros with the derived gains:

Kds

2 + Kps + Ki = 0 ⇒ z1,2 ≈ −21,524 and − 67,979 rad/s | (34)

z1 ≈ −21,524 rad/s sits almost on top of the dominant pole (p1 = −20,000 rad/s, Section 4.3) – a near pole-zero cancellation. When a zero nearly cancels the dominant (slowest) pole, the visible response is no longer dominated by that ∼ 200 µs time constant – it is dominated by the remaining, much faster dynamics (the non-dominant poles at −150,000 rad/s, τ ≈ 6.7 µs, and the second zero at z2 ≈ −67,979 rad/s, τ ≈ 14.7 µs), which matches the observed 11–31 µs transient far better than the design’s nominal 200 µs target. A real pole-zero pair (both on the negative real axis, not complex) can still produce step-response overshoot when imperfectly cancelled – a real, documented limitation of the pole-placement method used, not a simulation artifact.
Decision: the 11.54 % result is accepted as final for this project phase, given the trade-off explored in Section 6.4.

### 6.4 Pole placement revisited: why not just re-tune?

A systematic search (varying the dominant pole magnitude and its separation ratio from the non-dominant poles, and separately trying a complex dominant pole pair with ζ = 0.7) found that a zero landing near the dominant pole is a persistent, structural feature of this plant-plus-PID combination, not a poor choice of one specific pole triple: every fast/practical candidate tested still put a zero within 4–25 % of the dominant pole. Materially improving that separation required slowing the dominant pole down (e.g. to ∼5000 rad/s, τ ≈ 800 µs) – slower than the open-loop response itself, defeating the purpose of adding control. This trade-off (speed vs. overshoot, given this specific plant) is the actual reason 11.54 % was accepted rather than chased further.

### 7 Conclusions

1. The open-loop plant matched its analytical prediction almost exactly (52.68 % simulated vs. 52.7 % calculated overshoot), validating both the transfer-function derivation (Section 3) and its SPICE implementation before any control was added.
2. A parallel PID, designed by direct algebraic pole placement (3 free gains for a 3rd-order closed-loop characteristic equation, Section 4), reduced the overshoot from 52.68 % (open-loop) to 11.54 % (closed-loop) – a large, real improvement, though not the 0 % the all-real-pole criterion predicted.
3. Key limitation found: an all-real-pole closed-loop design guarantees no oscillatory pole, but does not by itself guarantee zero step-response overshoot, because the PID contributes its own zeros to the closed-loop transfer function. For this plant, a zero consistently lands near the dominant pole across a wide range of pole choices (Section 6.5) – a structural property of this specific plant-plus-PID combination, confirmed by systematically searching the design space, not a one-off tuning mistake.
4. Two real LTspice pitfalls were hit and resolved during closed-loop debugging: the generic opamp symbol requires a manual .lib opamp.sub directive, and that same symbol’s default gain-bandwidth product (10MHz) was not fast enough for this specific design (five cascaded stages, Kp ≈ 27.87) without destabilizing the loop – both documented in Section 6.2 so they are not rediscovered from scratch on the next project (the PID-controlled buck).
5. The op-amp compensator was fully specified with real, standard component values (Rp = Ri = Rf d = Rs = Rfs = 10 kΩ, Rf p ≈ 278.7 kΩ, Ci ≈ 219.3 pF, R1 ≈ 16.06 Ω, Cd ≈ 31.14 nF, Section 5), and the filtered-derivative design (a lead network, not an ideal differentiator) was carried through consistently to avoid amplifying switching/measurement noise.
6. 11.54 % overshoot, well-characterized and understood, is accepted as the final result for this project phase rather than chased further, given the documented speed-vs-overshoot trade-off (Section 6.5).
