UAA-F14/PID-RLC/design/design/logFile.md

# Log File
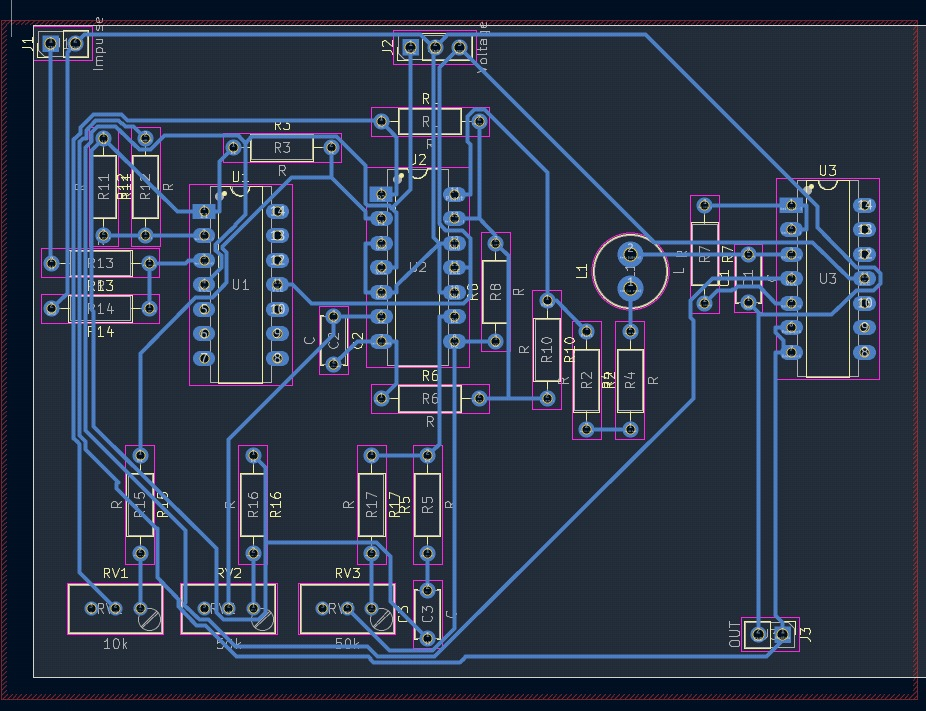
[picture p21: design/design/src/logFile/image.png]


# 10-16 
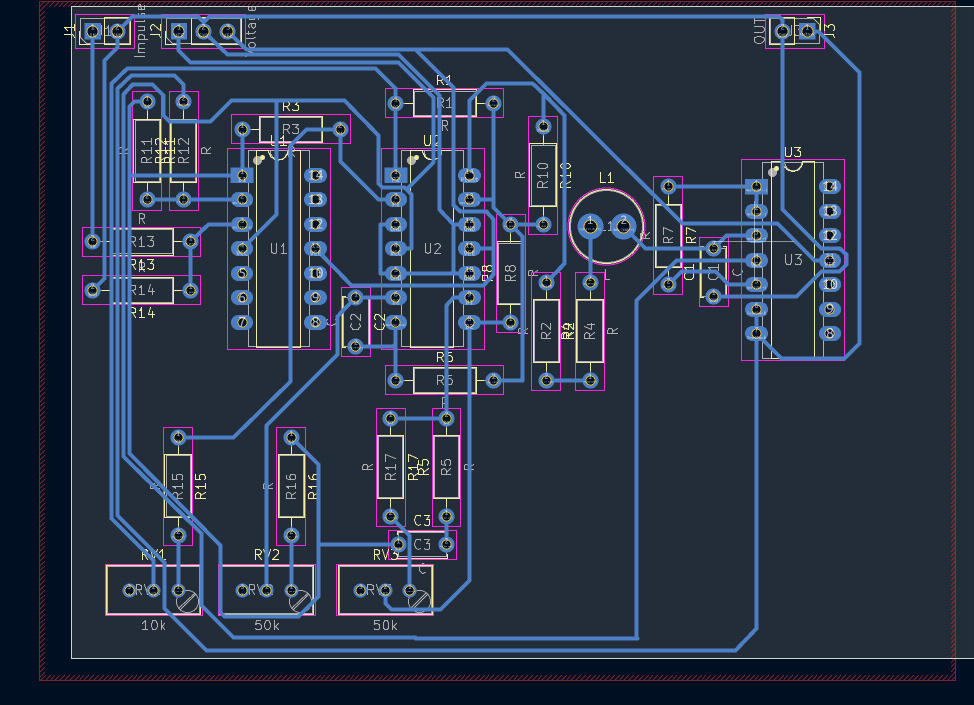
[picture p22: design/design/src/logFile/image-1.png]
