UAA-F14/PID-RLC/doc/src/PY_2/Control_E.png

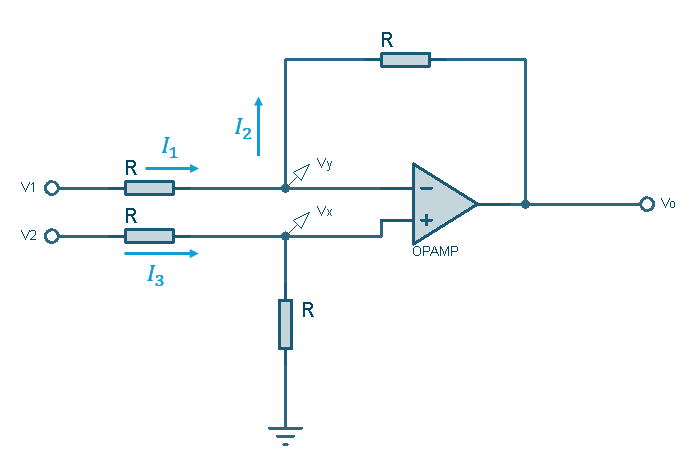
doc/src/PY_2/Control_E.png
