UAA-F14/PID-RLC/sim/RLC.asc

100: res; 127.32
C1: cap; 100nF
C2: cap; 219.3p
C3: cap; 31.14n
C4: cap; 100nF
C5: cap; 100nF
C6: cap; 1n
C7: cap; 1n
C8: cap; 100nF
C9: cap; 10n
C10: cap; 10n
L1: ind; 10.13mH; Rser=1m
L2: ind; 10.13mH; Rser=1m
L3: ind; 10m; Rser=1m
L4: ind; 10m; Rser=1m
R1: res; 127.32
R2: res; 10k
R3: res; 10k
R4: res; 10k
R5: res; 10k
R6: res; 10k
R7: res; 10k
R8: res; 16.06
R9: res; 278.7k
R10: res; 10k
R11: res; 10k
R12: res; 10k
R13: res; 10k
R14: res; 10k
R15: res; 127.32
R16: res; 100
R17: res; 10k
R18: res; 10k
R19: res; 10k
R20: res; 10k
R21: res; 10k
R22: res; 83.33k
R23: res; 2.4k
R24: res; 15k
R25: res; 65k
R26: res; 10k
R27: res; 10k
R28: res; 10k
R29: res; 10k
R30: res; 58
R31: res; 20k
R33: res; 20k
R34: res; 58
U1: opamp
U2: opamp
U3: opamp
U4: opamp
U5: opamp
U6: ADTL082
U7: ADTL082
U8: ADTL082
U9: ADTL082
U10: ADTL082
U11: ADTL082
U12: ADTL082
U13: ADTL082
U14: ADTL082
V1: voltage; PULSE(0 10 0 10u 10u 10 10)
V2: voltage; PULSE(0 10 0 10u 10u 10 10)
V3: voltage; PULSE(0 1  0 10u 10u 5m 10)
V4: voltage; PULSE(0 1  0 10u 10u 5m 10)
V5: voltage; 12
V6: voltage; -12
Named nets: 0, VCC, VEE
.lib opamp.sub
.tran 5m
