UAA-F14/PID-RLC/design/design/design.kicad_pcb

## KiCad design design/design/design.kicad_pcb (2026-10-27)

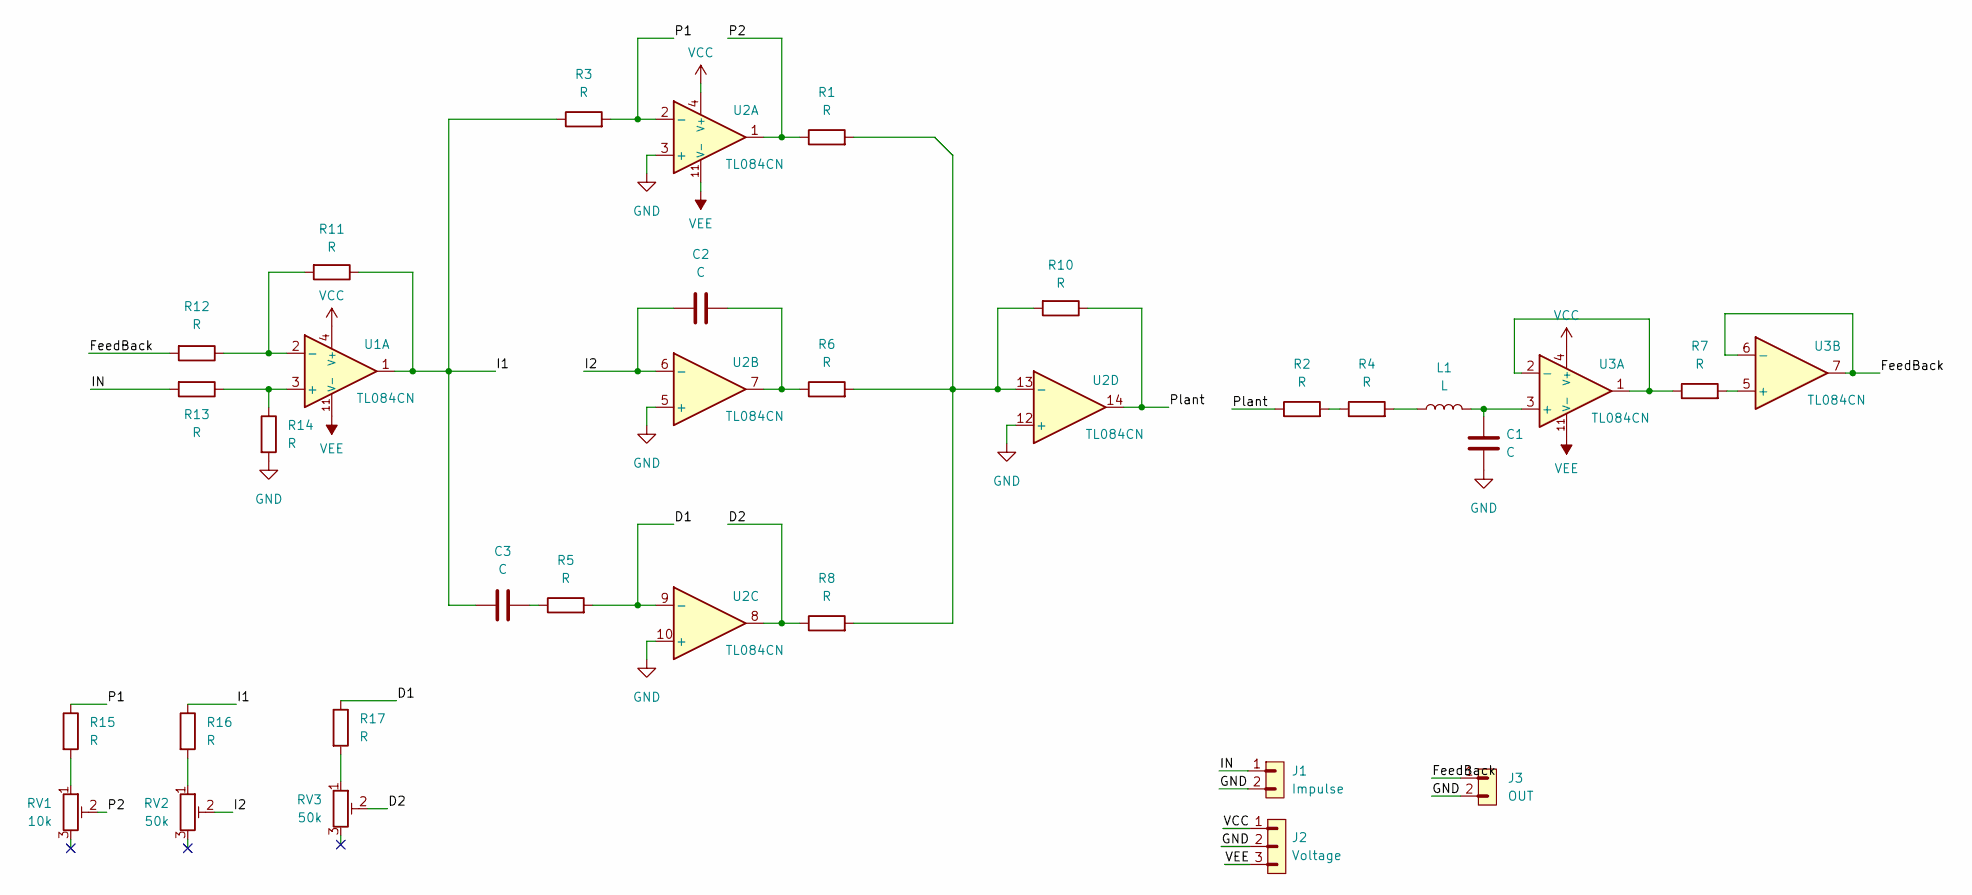
[picture p28: schematic design.kicad_sch]

Parts:
C1, C2, C3: C; C_Disc_D5.0mm_W2.5mm_P5.00mm
J1: Impulse; PinHeader_1x02_P2.54mm_Vertical
J2: Voltage; PinHeader_1x03_P2.54mm_Vertical
J3: OUT; PinHeader_1x02_P2.54mm_Vertical
L1: L; L_Radial_D7.5mm_P3.50mm_Fastron_07P
R1, R2, R3, R4, R5, R6, R7, R8, R10, R11, R12, R13, R14, R15, R16, R17: R; R_Axial_DIN0207_L6.3mm_D2.5mm_P10.16mm_Horizontal
RV1: 10k; Potentiometer_Bourns_3296W_Vertical
RV2, RV3: 50k; Potentiometer_Bourns_3296W_Vertical
U1, U2, U3: TL084CN; DIP-14_W7.62mm_LongPads

Connections:
/D1: R5.2, R17.1, U2.9 (-)
/D2: R8.1, RV3.2, U2.8
/FeedBack: J3.1, R12.2, U3.6 (-), U3.7
/I1: C3.1, R3.1, R11.1, R16.1, U1.1
/I2: C2.1, RV2.2, U2.6 (-)
/IN: J1.1, R13.2
/P1: R3.2, R15.1, U2.2 (-)
/P2: R1.1, RV1.2, U2.1
/Plant: R2.1, R10.1, U2.14
GND: C1.1, J1.2, J2.2, J3.2, R14.2, U2.3 (+), U2.5 (+), U2.10 (+), U2.12 (+); also elsewhere on the board
unnamed: C2.2, R6.1, U2.7
unnamed: C3.2, R5.1
unnamed: L1.1, R4.2
unnamed: R2.2, R4.1
unnamed: R15.2, RV1.1
unnamed: R16.2, RV2.1
unnamed: R17.2, RV3.1
unnamed: R13.1, R14.1, U1.3 (+)
unnamed: R11.2, R12.1, U1.2 (-)
unnamed: R1.2, R6.2, R8.2, R10.2, U2.13 (-)
unnamed: C1.2, L1.2, U3.3 (+)
unnamed: R7.1, U3.1, U3.2 (-)
unnamed 22: R7.2, U3.5 (+); also elsewhere on the board
VCC: J2.1, U1.4 (V+), U2.4 (V+), U3.4 (V+)
VEE: J2.3, U1.11 (V-), U2.11 (V-), U3.11 (V-)

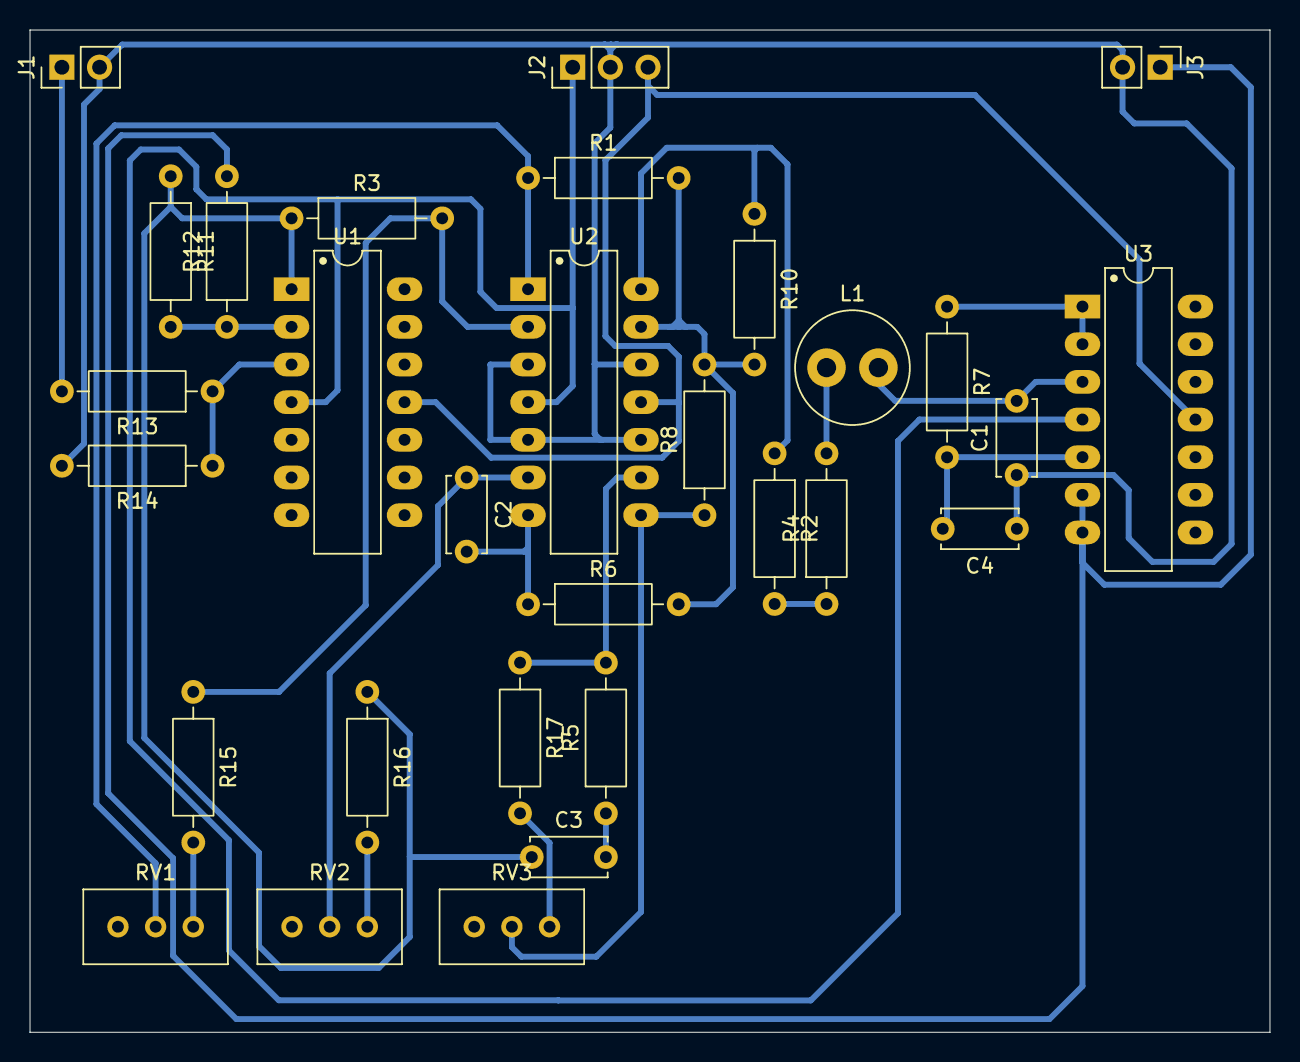
[picture p29: board design.kicad_pcb from above]

Board: 2 copper layers, 83.6 x 67.6 mm, 30 parts (0 on the bottom side), 25 nets.

Other parts of the board:
C4: C; C_Disc_D5.0mm_W2.5mm_P5.00mm

Their connections:
GND: C4.1; also elsewhere on the board
unnamed 22: C4.2; also elsewhere on the board
