UAA-F14/PID-RLC/(commit log)

2026-09-30 chore : git ignore kicad and tex
2026-09-30 feat: add TL072 PID RLC on sim
2026-09-30 feat: add BOM script
2026-10-12 feat: create kicad dsn
2026-10-13 PID VALUES
2026-10-13 PID VALUES sintonized
2026-10-16 feat: PCB routed
2026-10-16 feat: PCB rearrange
2026-10-20 fix: add cap on pcb and design
2026-10-21 chore: minor fixes on traces
2026-10-27 docs: Add Doc-PID
